tanep3/PicoW_Youtube_Player/hardware/case/slim-v3/stl/README_JA.md

# SLIM v3 試作STL — 最初に開くファイル

- 一括配置：00_all_parts_A1mini.stl を1つだけ読み込む
- 個別配置：01_shell.stl、02_lid.stl、03_button_row_1.stl、04_button_row_2.stl を読み込む
- **一括版と個別版を同時に読み込まないでください。部品が重複します**
- 単位mm・倍率100%。本体の横幅64mmになっていることを確認
- 一括配置の外接寸法140×56.6×24.4mm。A1 miniの180mm角内に収まる4部品
- LCD保持板05/06は廃止。4つのLCD爪は本体に一体化済み
- v3の本体とv3の蓋を組み合わせて使用。まず電子部品を入れず蓋の掛かりを確認

STL ZIPには5つのSTL、一括配置プレビュー、組立説明図、検査JSON、書出し・検査用スクリプトを含みます。Blenderファイルとモデル再生成ソースは別配布のBlender ZIPです。

## 設計と組立の詳細

v2試作の「蓋が緩い」「LCD保持板を入れづらい」「Picoを爪の下へ入れられない」を受けた改訂です。v2ファイルは変更していません。今回はBlenderモデルと、4部品の試作STLを用意しています。

**実物の嵌合・材料強度は未検証です。CADでの閉状態と挿入経路の確認に合格しても、印刷成功やクリック感を保証するものではありません。無理に押し込まず、まず部品なしで蓋を試してください。**

## 変更点

1. 蓋：壁への掛かり量を0.20→0.40mm、掛かり肩の奥行き遊びを0.25→0.12mm、位置決めリングの片側隙間を0.30→0.15mmに変更
2. LCD：別体の上下保持板を廃止し、本体一体の四隅の弾性爪に変更。ガラス窓と右FPCを避け、PCBの上下端の角を保持
3. Pico：上から被さる本体爪を撤去。左2つの穴周辺の座と、ボタン列間の中央支柱で下から支え、蓋側の4本の穴位置決めピン＋肩で移動を制限
4. 内深さを20→22mm、Picoを蓋側へ2mm移動。USB口を背面まで開け、USB金属部が出た基板も背面からまっすぐ入れられる形に変更

正面の窓、4ボタンの中心・軸穴・座面、側面の波形は維持しています。ロゴはありません。右側のPico穴の下に固定腕を設けず、スイッチの差込み経路を空けています。

## 主要寸法（mm）

- 基準外形：64×32×26.8。波形を含む最大横寸法は約64×32.7
- 前内面Z0、蓋内面Z22、前外面Z−2.4、蓋外面Z24.4
- LCD実測：30×24.02×3.2、原点X4/Y4.1/Z0
- 窓：23×13.8、PCB左上から右0.9・下5.3。開口X4.9〜27.9、Y9.4〜23.2
- LCDヘッダは正面下側。FPCは正面右側へ1mm
- Pico：51×21×1、原点X5/Y2.8/Z16.8、USB左
- Picoソケットの仮定最下部Z8.3、ボタンレール上端Z6.05。隙間2.25（v2は0.25）
- 仮定RFシールド上端Z21、蓋内面との隙間1.0
- 4ボタン中心：X43/56、Y10/22。ポケット6.2角、軸穴φ4、外面から座面1.6

Zは正面から背面に向かう方向です。22mmは基準面間の内深さであり、支持材を含めた全域が空洞という意味ではありません。

## Picoの保持と位置合わせ

公式図の穴はφ2.1±0.05、47×11.4の配置です。ケース内の中心は(7,7.6)、(7,19)、(54,7.6)、(54,19)。基板厚1mmとヘッダ列中心Y4.41/22.19も公式寸法に合わせました。

- 本体支持：左2穴の周囲のφ3.2座＋中央支柱X41.2〜44/Y14.7〜17.3。中央支柱はアンテナ領域の手前
- 左座には蓋ピン用のφ2.3逃げを設けています
- 蓋：4穴に入るピン。対角2本はφ1.65、残り2本はφ1.30で、4本全てをきつく拘束しない設定
- ピン先端には0.4mmの導入テーパ。先端Z16.15、基板上面Z17.8
- 蓋の押さえ肩はφ3.2、下端Z17.92。基板上面との公称隙間0.12
- 本体の左辺・上辺には上から被さらない位置合わせガイドがあります。Picoを左と上のガイドに合わせて置き、ピンが4穴に入るのを確認して閉じてください

0.12mmは基板を曲げて強く締め付けるための圧縮量ではなく、動きを制限する隙間です。蓋爪側の奥行き遊びも最大0.12mmあるため、積み上げ上の基板移動余裕は最大約0.24mmとなり得ます。無負荷で完全にがたゼロになることや、実ソケットが支柱と干渉しないことは実機確認が必要です。

公式出典：
- https://datasheets.raspberrypi.com/picow/pico-w-product-brief.pdf （機械図）
- https://datasheets.raspberrypi.com/picow/pico-w-datasheet.pdf （基板・穴・アンテナ仕様）

穴の寸法は周囲の任意の大きさの押さえ面まで安全と保証するものではありません。実基板の部品・はんだ・ソケットを目視して、φ3.2の接触面に重ならないことを確認してください。アンテナ周囲の樹脂もRF性能へ影響し得るため、通信距離は未検証です。

## LCDの四隅爪

- 爪位置：X6.1/32.0、PCBの上端と下端の計4か所
- 梁幅2.0、厚0.70、根元Z−1.2、保持肩Z3.35
- 根元を内側へ掘り込み、有効腕長4.55。外側の前板は1.2mm残るため貫通穴にはしません
- PCB端への掛かり0.25、想定外向き移動0.30、厚さ方向の遊び0.15
- 外向きの空きは上0.75・下0.58。根元まで分離溝があり、固定柱ではなく実際に曲げられる形
- 挿入側に斜面。ガラス窓やFPCではなくPCB四隅を押して装着します

接触可能な実PCBの縁、ガラス外周、背面部品は未実測です。まず実LCDで爪がPCBだけに掛かることを確認し、ガラスやFPCに力が入る場合は中止してください。爪を外す場合は先にPicoを外し、爪をわずかに外へ逃がします。

## 組立順序：LCDの経路を含む

1. 蓋、Pico、ボタン保持板を外した空の本体から開始
2. LCDを最終位置より右（ボタン側）へ5.5mmずらす。PCB左上はX9.5/Y4.1。ヘッダ下・FPC右の向きを保つ
3. その位置で背面からまっすぐ下ろし、PCBの前面をZ6.8（前板内面から6.8mm）付近に置く。PCB後面はZ10.0
4. この高さのままLCDを左（窓側）へ5.5mm滑らせて最終X4へ。左側の高いPico座の下を通す。ヘッダやFPCを座に引っ掛けない
5. 最終位置で四隅のPCB縁を少しずつ押し、4つの爪を越えて前板へ座らせる。ガラス面を押さない
6. スイッチ4個を背面からまっすぐ各ポケットへ入れる。実端子がレール用の逃げに沿うことを確認
7. 上下段の保持板をLCD側から右（+X）へ滑らせる。Picoはまだ載せない
8. 配線と実ソケット・はんだを確認してからPicoを背面からまっすぐ下ろす。USBは背面まで開いた左口へ通る。左・上の位置合わせガイドに寄せる
9. 蓋の4ピンをPicoの4穴へ合わせ、配線を噛まないことを確認。左右の爪が順に掛かるまで押す

LCD仮置き経路の公称最小隙間は、左座とのX方向0.9、FPCと中央支柱のX方向0.7。左へ滑らせる高さでは、PCB後面Z10と左腕下面の隙間が約1.38あります。手で保持するための目安であり、治具なしでこの数値が自動的に決まるわけではありません。LCDはPico・ボタン板より先に入れてください。

蓋を外すときは側面の小さい解除孔から爪を少し内側へ押して順番に外します。工具を電子部品へ突き込まないでください。

## 蓋のたわみ

- 梁厚0.9、幅3.4、根元の分離位置Z21.5
- 爪先Z13、肩Z15、有効腕長6.5。v2より長くして、掛かり増加による曲げを抑制
- 壁越えのたわみ0.4、掛かり肩の遊び0.12、リング片側隙間0.15
- 単純な小変形片持ち梁式による公称根元ひずみ目安：約1.28%。LCD爪は約1.52%

これはFEA、積層方向強度、挿入力、疲労、実際の材料の評価ではありません。PETGなどの弾性を確認した材料で小さく試し、PLAを含む各材料の繰り返し着脱耐久は別途確認してください。

## 別配布Blenderセットのファイル・シーン

- YouTube_LCD_Case_SLIM_Fit_v3.blend：編集用、1 Blender単位＝1mm
- build_youtube_case_v3.py：再生成ソース。SKIP_RENDERS=1ならレンダー省略
- render_v3.py：保存済みシーンのレンダー再生成
- validation.json：寸法、閉状態の主要干渉、印刷部品メッシュ検査
- assembly_path_audit.json：独立した連続挿入経路の幾何検査
- 01〜09のPNG：外観、正面、背面、断面、分解、背面開放、蓋裏、本体内側、LCD爪詳細
- 10_assembly_guide.png：位置合わせ・支持点・積み上げ寸法の説明図

基準シーンは01_ASSEMBLED_DRAFT_mm。残りは独立コピーの説明用シーンです。PRINTは印刷物、REFは電子部品の参考外形。4つの印刷物は本体、蓋、上段ボタン板、下段ボタン板のみです。廃止したLCD板は含みません。

## 印刷・未確定事項

STLはmm、100%で使用してください。本体は正面外側をベッド、蓋は平らな背面外側をベッド、保持板は広い平面をベッドにする配置です。STLには見栄え用のBevel修飾を含めず、検査した本体メッシュだけを使っています。

レール屋根や左座の裏などのオーバーハングはスライサーで確認し、必要箇所にのみサポートを付けてください。LCD爪の細い可動溝を埋めたり、除去で爪を折ったりしないよう注意。0.70mmの爪がスライスで欠けず、連続した線として出ることを必ず確認してください。スライス済み3MF/G-code、サポート、ブリムは付属しません。

実LCDヘッダ高さ、ソケット長さ・幅・高さ、スイッチ端子・軸・ストローク、USBケーブル外装、はんだ盛り、配線曲げは未実測の部分を含みます。参考ソケット外形は49.26×2.6×8.3です。経路検査はこの剛体外形が対象で、すべての実装済み配線やはんだを保証するものではありません。端子だけの参考表示や配線曲線は全配線のモデルではありません。

本体と蓋は必ずv3同士で使ってください。v2の蓋・本体との互換性はありません。ボタン保持板の基礎寸法は維持していますが、v3同梱データを使うと取り違いを避けられます。
