tanep3/PicoW_Youtube_Player/docs/images/web-player-dark-desktop.png

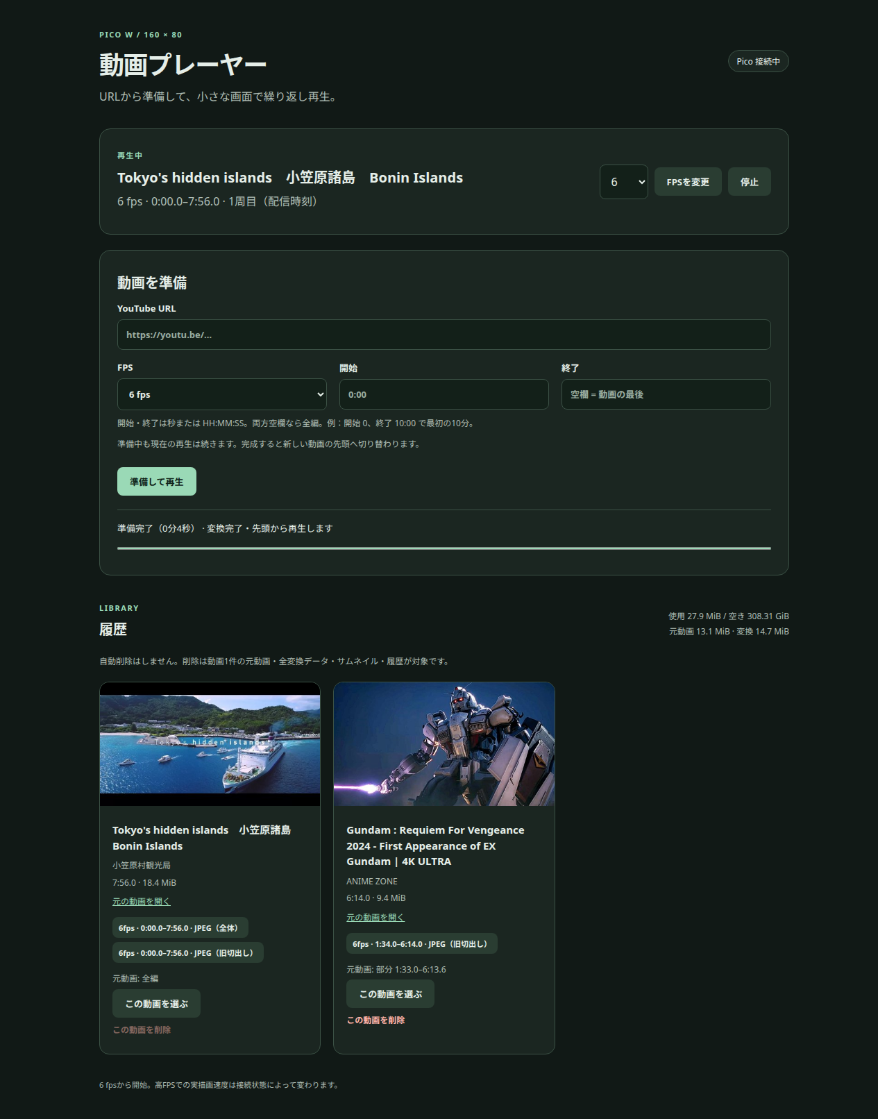
docs/images/web-player-dark-desktop.png
