tanep3/PicoW_Youtube_Player/docs/images/web-player-dark-mobile.png

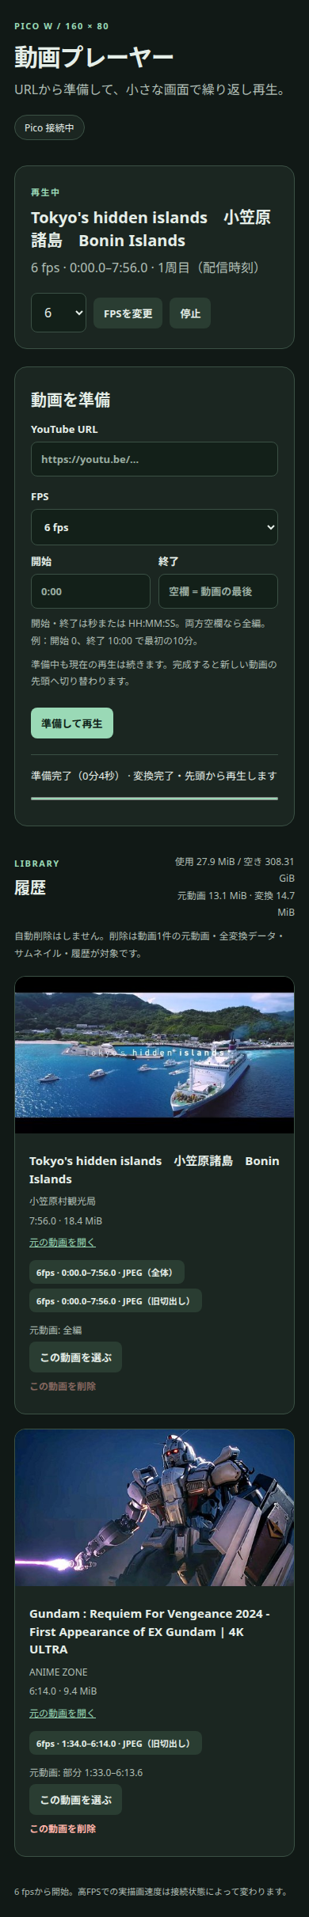
docs/images/web-player-dark-mobile.png
