tanep3/PicoW_Youtube_Player/docs/images/web-player-desktop.png

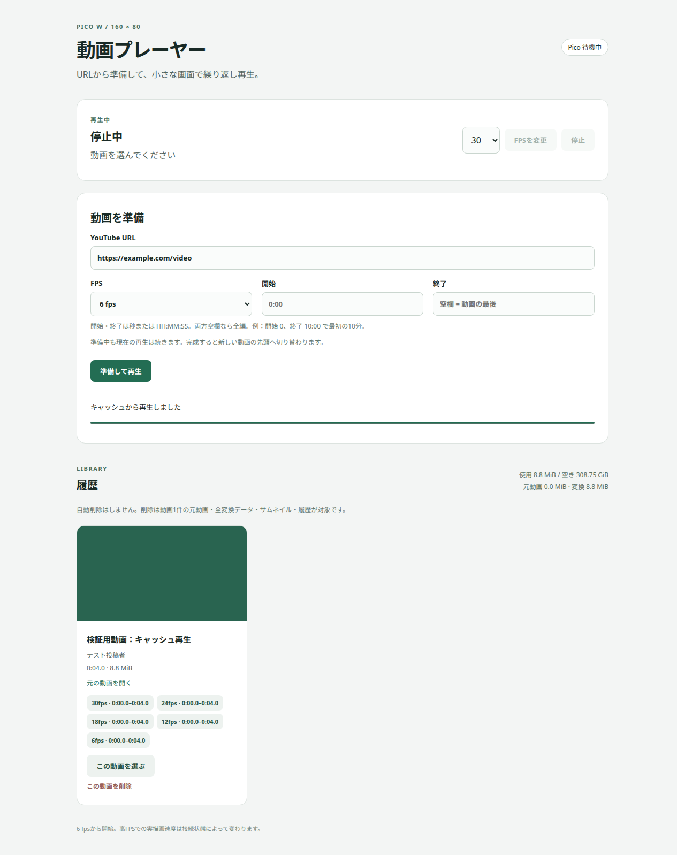
docs/images/web-player-desktop.png
