tanep3/PicoW_Youtube_Player/hardware/case/slim-v3/blender/02_front_orthographic.png

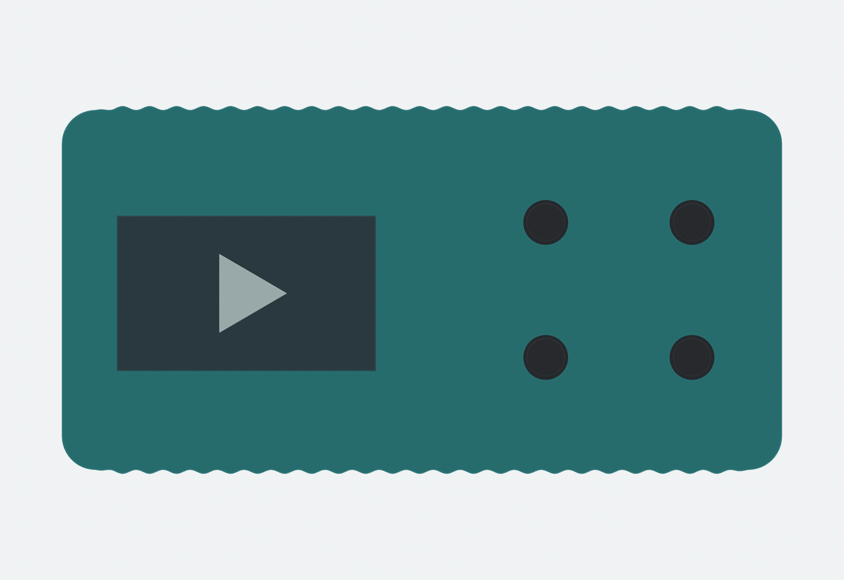
hardware/case/slim-v3/blender/02_front_orthographic.png
