tanep3/PicoW_Youtube_Player/hardware/case/slim-v3/blender/03_back_3quarter.png

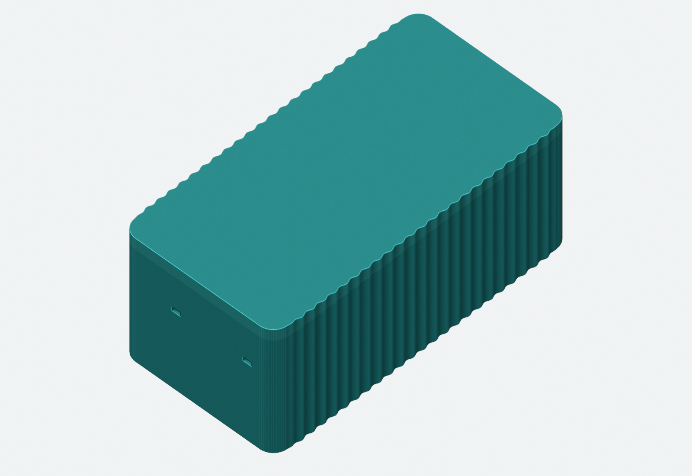
hardware/case/slim-v3/blender/03_back_3quarter.png
