tanep3/PicoW_Youtube_Player/hardware/case/slim-v3/blender/04_cutaway.png

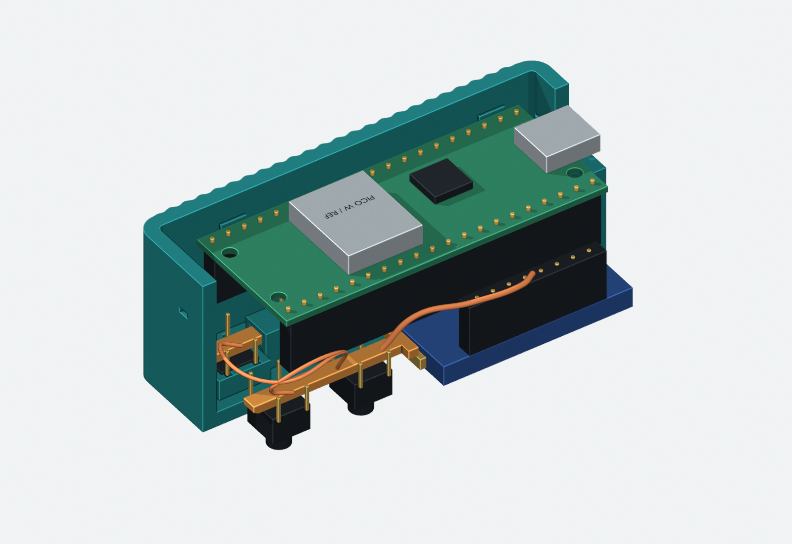
hardware/case/slim-v3/blender/04_cutaway.png
