tanep3/PicoW_Youtube_Player/hardware/case/slim-v3/blender/05_exploded.png

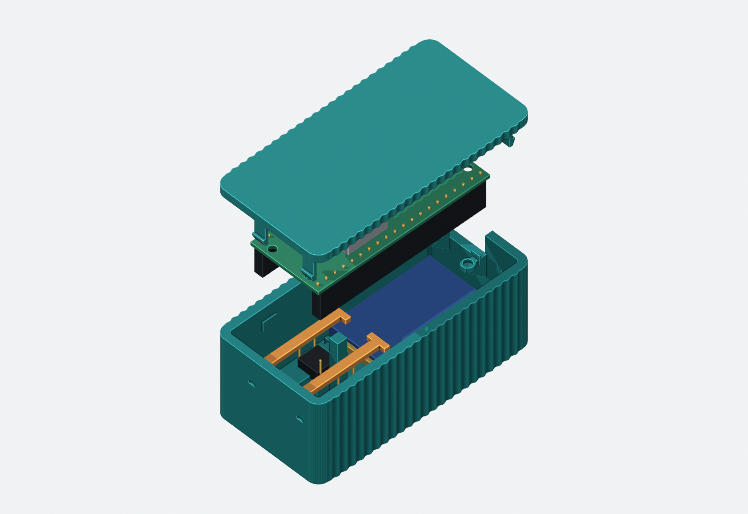
hardware/case/slim-v3/blender/05_exploded.png
