tanep3/PicoW_Youtube_Player/hardware/case/slim-v3/blender/06_rear_open.png

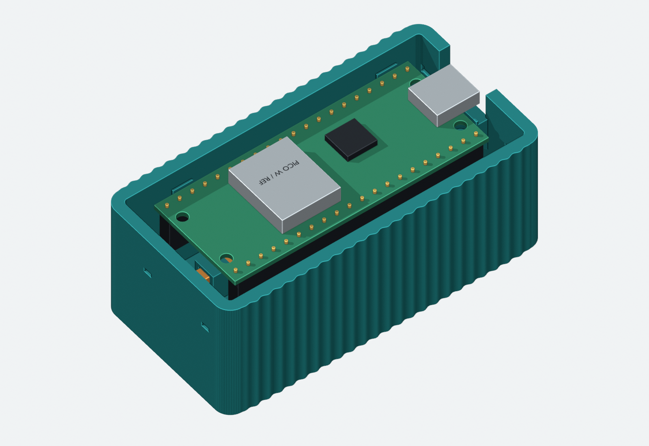
hardware/case/slim-v3/blender/06_rear_open.png
