tanep3/PicoW_Youtube_Player/hardware/case/slim-v3/blender/07_lid_snap_detail.png

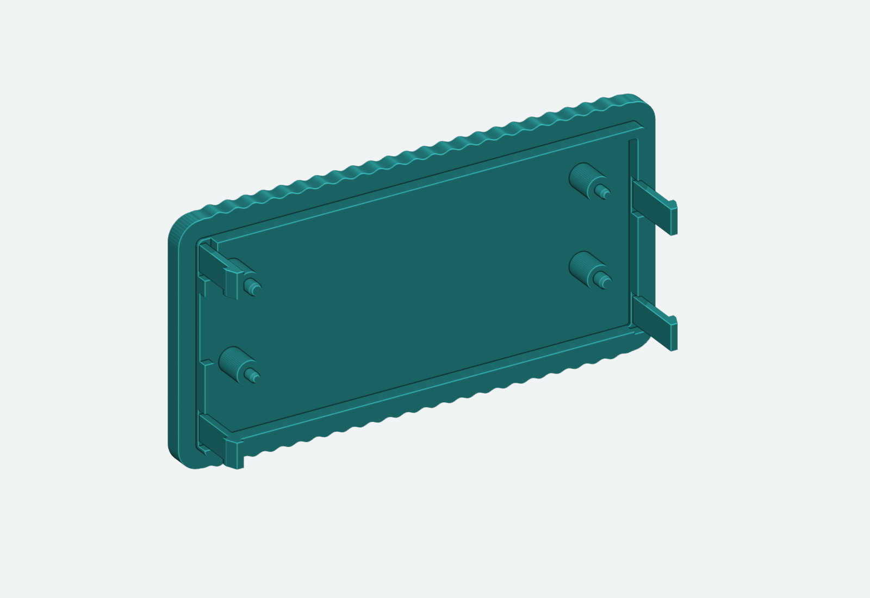
hardware/case/slim-v3/blender/07_lid_snap_detail.png
