tanep3/PicoW_Youtube_Player/hardware/case/slim-v3/blender/08_integral_tabs_and_hole_seats.png

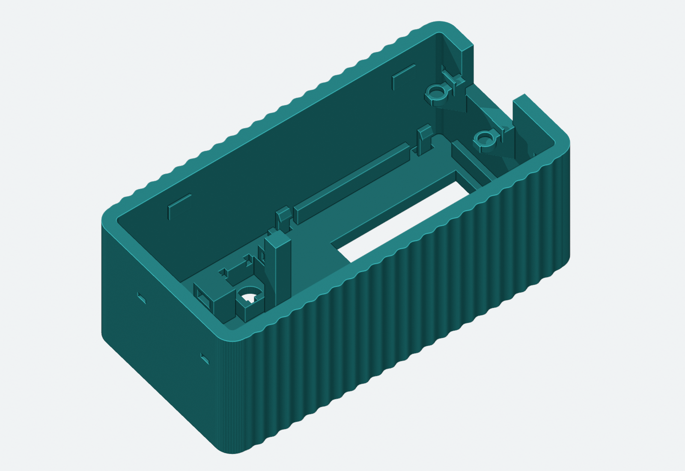
hardware/case/slim-v3/blender/08_integral_tabs_and_hole_seats.png
