tanep3/PicoW_Youtube_Player/docs/YOUTUBE_REQUIREMENTS_INVENTORY.md

# YouTube構築へ向けた既存要件の棚卸し（実装前の記録）

> 実装開始後の追記: 単一動画ループ、取得/変換中の現在再生継続、完成後先頭切替、SQLite/data、1動画全データの確認削除（停止/取消し後）、全編既定と開始終了、範囲別元/変換キャッシュが確定した。現実装・起動・検証・残る依存ブロッカーは[Webプレーヤー仕様](WEB_PLAYER.md)を参照。以下の「未決」「未実装」は棚卸し時点の履歴。

2026-10-08。検証フェーズをFixし、Wi-Fi `192.168.0.120` / 6fpsへ戻して次フェーズへ進むというユーザー決定を記録する。最新指示で**AI/Gemini連携は今回スコープ外**。URL直接入力、FPS選択、キャッシュ/履歴、使用量表示/手動削除を対象にする。ハブ到着後は有線化・30fps改訂と、サーバーIP `.120`を保持する計画。移行方法は未決で、今回は適用していない。ここでは文書の要件調整だけを行い、新実装・常駐化・恒久有線化・コミットを開始していない。

## 根拠

- [README](../README.md): 現プロジェクトは既存JPEG連番の映像検証。YouTube取得、検索UI、常駐サービスを含まない。160×80、RGB565、RAW/JPEGのTCP比較、再接続、単調時計、エンドレス再生を実装している。
- [有線/FPS検証](diagnostics/WIRED_ETH0_PREP.md): 有線RAW6fps描画6.00fps、32fps設定で最高実描画約30fps。高fpsで使った素材は6fps画像の速送りで、ネイティブ高fps動画の検証ではない。Wi-Fi運用には再送・フレーム破棄・再接続による停止が残る。
- 次フェーズのユーザー要望（親チャットからの伝達）: **WebでURL指定 / ffmpegで160×80へ変換 / 24時間連続再生 / 動画・変換データのキャッシュ / 履歴から再選択 / 使用量表示と手動削除**。履歴は**サムネイル、動画タイトル、投稿者/チャンネル名**を表示し、表示メタデータもキャッシュする。WebのFPSドロップダウンは **6 / 12 / 18 / 24 / 30fps**。初期6fpsで構築し、将来30fpsへ改訂する。有線移行後もPi5のサーバーIP `.120`を保持する計画。
- 先に検討した自然文AI検索/Gemini連携は、最新ユーザー指示により今回の対象から外れた。登録済Gemini CLI/キー設定には触れず、AI実装・実験を行わない。

## 機能の現況

Pi5で`/usr/bin/ffmpeg`と`/usr/local/bin/yt-dlp`の実行ファイルが存在することを読み取り確認した。yt-dlp/ffmpeg更新は別タスク担当中。この文書更新では取得・検索の実行やインストールをしていない。現在のPython依存はPillowだけで、Web用の依存は未選定。動画とメタデータ取得へのyt-dlp活用を検討する。検索APIやAI連携を追加するという決定ではない。

Gemini CLIの実動作、認証継承、モデル利用可否は未検証のまま。今回スコープ外となったため、検証のためのCLI実行や認証/秘密値の読取りも行わない。

| 要件 | 利用できる現基盤 | 次フェーズで必要なもの |
|---|---|---|
| WebでURL指定 | Pi5上のPython映像サーバー。検索/指定UIはない | URL入力、取得/変換/再生の開始と状態表示 |
| 動画取得 | 既存JPEGを読み取るだけ | URL等からの取得手順と失敗時の扱い |
| WebのFPS指定 | 未実装。既存CLIは任意の正整数fpsを扱える | ドロップダウン6/12/18/24/30、変更時の変換と切替 |
| ffmpeg変換 | ユーザー申告の変換コマンドをREADMEへ記録済み。自動実行は未実装 | 取得動画から160×80・指定FPS（初期6fps）への変換、出力先、進捗/失敗の扱い |
| 元動画・変換データのキャッシュ | 未実装 | videoIDで元動画の重複取得を避け、変換条件別に完成データを再利用する |
| 履歴から再選択再生 | 未実装 | サムネイル・動画タイトル・投稿者/チャンネル名を表示し、キャッシュから再生する |
| メタデータのキャッシュ | 未実装 | 履歴表示用メタデータとサムネイルを保持し、再選択のたびの再取得を避ける |
| 使用量表示・手動削除 | 未実装 | キャッシュ使用量の表示、削除対象/範囲の確認。自動削除しない |
| Pi5からPicoへ送る | JPEGをPillowでRAW RGB565へ変換してTCP配信。PWF2固定ヘッダー、再接続、色補正あり | Web操作と既存配信の接続、動画切替 |
| 24時間連続再生 | 単一JPEGフォルダーをエンドレス再生。切断後も共有再生時刻から継続。24時間耐久は未試験 | 単一動画ループ/複数動画連続の仕様、追加/停止/切替、失敗復帰と24時間耐久検証 |
| 運用 | 手動起動、一台のPico向け。既存本番16150は使わず、試験は16151 | 新システムのポート、継続稼働と再起動の方法、設定先。今回の棚卸しではサービス変更を行わない |

## 確定したキャッシュ・履歴・容量管理

- **元動画:** videoIDを識別子として、同じ動画の重複ダウンロードを避ける。
- **変換済データ:** `videoID + 解像度 + FPS + 変換条件`で区別する。異なるFPSやクロップ等の条件を同じ完成キャッシュとして再利用しない。変換条件の表現と保存形式は未決。
- **完成状態:** ダウンロード/変換の途中・失敗したファイルを完成キャッシュにしない。完成データだけを再利用可能な履歴再生対象として扱う。未完データの保存/再開/手動削除の扱いは設計時に決める。
- **履歴表示:** サムネイル、動画タイトル、投稿者/チャンネル名を表示する。表示メタデータもキャッシュし、再選択時には保存済み情報を利用する。
- **再選択:** 完成済みの同じ変換条件があれば再生に再利用する。元動画だけがある場合は、指定FPS等の変換データを作る。元動画・変換済データ・メタデータの完了状態を混同しない。
- **容量管理:** 使用量表示と手動削除を実装する。自動削除しない。削除する対象と範囲を利用者に確認できるようにする。再生中/変換中の対象への削除操作は未決。

### メタデータ欠損時の表示案（未確定）

- サムネイル欠損: 共通プレースホルダー画像。
- タイトル欠損: 「タイトル未取得」とvideoIDを表示。
- 投稿者/チャンネル名欠損: 「投稿者不明」を表示。
- 動画/変換データが完成していれば、表示メタデータの欠損だけで再生を禁止しない案。メタデータの再取得を手動操作にするか、取得時に再試行するかは未決。

## 現在維持する条件

- 今回の復元先はPi5 Wi-Fi `.120`、Pico `.173`、6fps。PicoのST7735S/160×80/SPI0配線・Yoffset24・色補正は校正済み。
- ハブ到着後の有線移行でもサーバーIP `.120`を保持する計画。Wi-Fiの扱いと移行手順は未決で、試験時の一時IP `.116`を恒久接続先にはしない。
- 元JPEG `/home/tane/Videos/voltesV_6frame` は変更しない。新取得/変換の出力先は次フェーズで決める。
- 初期ffmpeg式はREADMEのユーザー申告を保持する。クロップ、アスペクト比、品質を変更する場合は新仕様として扱う。
- 音声は現検証に含まない。次フェーズで音声対応するという確定要件はない。
- 他の本番HTTP/timer/サービス、既存E-inkプロジェクト、共有SDK/driver、Wi-Fi秘密値は対象外。SSH、gitlink、remote設定、git pushは行わない。
- Gemini CLIと登録済キー設定は維持する。AI/Gemini連携は今回構築する機能に含めず、URL直接入力と履歴再生はGeminiに依存させない。

## 実装前にまとめて決める点

1. WebはURL指定を受け付ける。対象URLの範囲（YouTube以外も含むか）、操作端末、LAN内の利用範囲、必要な操作を決める。
2. キャッシュの保存先、履歴/メタデータの保存形式、videoID判定、変換条件キーの構成、完成判定と未完データの扱い。既存JPEGテストとは別の領域を使う。現`server/streamer.py`は全フレームをRAMへ保持するので、長時間動画と24時間のループ運用を区別して容量設計する。
3. 使用量の内訳/表示単位、削除対象と範囲（元動画のみ/変換データのみ/両方/履歴情報・サムネイルも含むか）、確認方法。再生/変換中は削除禁止にするか待機させるか等は未決。容量不足時も勝手に既存キャッシュを自動削除しない。
4. 24時間連続再生は要求済み。一動画ループかプレイリストか、新規指定の即切替/現在動画の終了待ち、停止/再開、取得失敗時の扱い。常時運用の起動/再起動方法。
5. WebのFPS候補は6/12/18/24/30で確定。条件一致キャッシュを再利用し、未キャッシュのFPSへ変更する際の変換中の再生/切替時点は未決。初期は校正済み6fps/160×80で進める。ハブ到着後の30fpsはネイティブ30fps変換と実受信/描画の再測定を伴う別改訂にする。
6. メタデータ欠損時の上記表示案、再取得/再試行、投稿者名とチャンネル名が異なる場合の表示、サムネイルの保存方法。
7. 有線移行後も`.120`を保持する具体的な方法と、Wi-Fi/他サービスへの影響を抑える移行手順。IP保持の方針を、両インターフェースに同じIPを無条件設定する指示と解釈しない。

## 推奨する初期スコープ（未確定）

- まずWebのURL入力→元動画キャッシュ→ffmpeg160×80/指定FPS変換キャッシュ→校正済みRAW TCP再生を通す。既存配信・再接続の基盤を利用する。
- 履歴カードにサムネイル/タイトル/投稿者を表示し、完成済み条件の再選択でダウンロード/変換を省ける動作を確認する。FPS選択、進捗/失敗/再生状態、使用量表示と手動削除を含める。
- 24時間連続再生の初期検証は、一動画を反復して切断/取得失敗/再起動からの復帰を確認する案。プレイリストの要否は別途決める。この案を確定仕様とは扱わない。
- 有線化/30fps/IP移行はハブ到着後。まず現在のWi-Fi `.120` / 6fpsで構築する。恒久化やIP移行をこの棚卸しで実行しない。

この文書は棚卸しであり、未決点を仮定して新しいUI/API、取得処理、サービスを作成していない。
