tanep3/PicoW_Youtube_Player/hardware/case/slim-v3/stl/00_all_parts_A1mini.stl

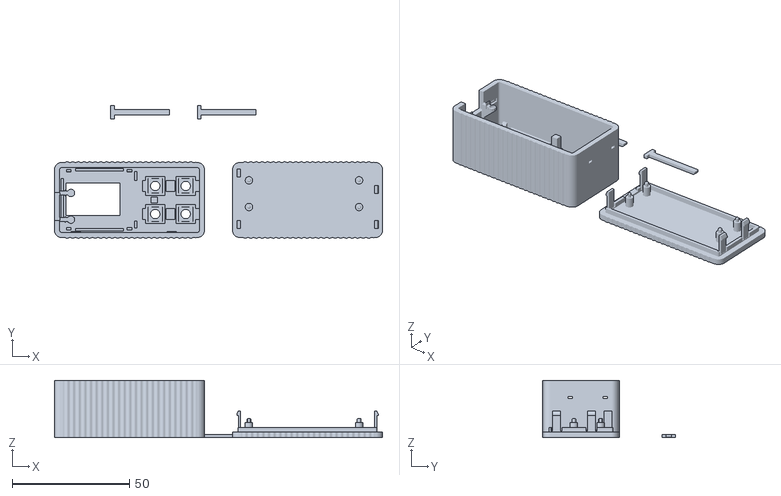
[picture p16: CAD file, 2026-10-10]
hardware/case/slim-v3/stl/00_all_parts_A1mini.stl
140.0 x 56.6 x 24.4
