tanep3/PicoW_Youtube_Player/hardware/case/slim-v3/stl/01_shell.stl

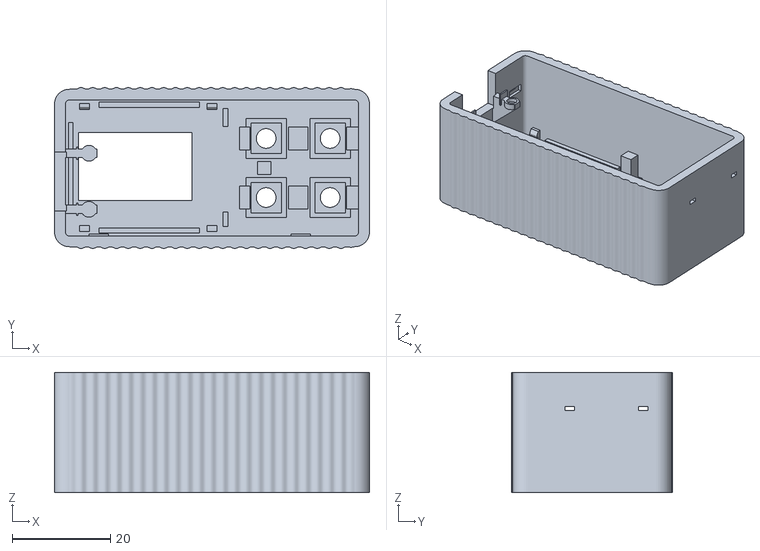
[picture p17: CAD file, 2026-10-10]
hardware/case/slim-v3/stl/01_shell.stl
64.0 x 32.7 x 24.4
