tanep3/PicoW_Youtube_Player/hardware/case/slim-v3/stl/04_button_row_2.stl

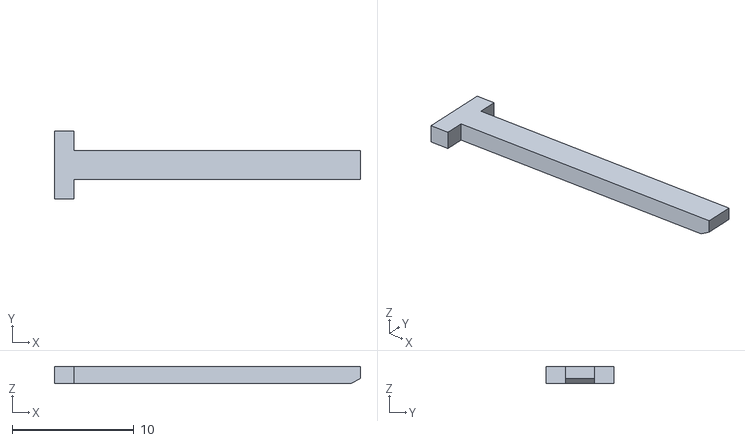
[picture p18: CAD file, 2026-10-10]
hardware/case/slim-v3/stl/04_button_row_2.stl
25.1 x 5.60 x 1.40
