tanep3/PicoW_Youtube_Player/hardware/case/slim-v3/stl/02_lid.stl

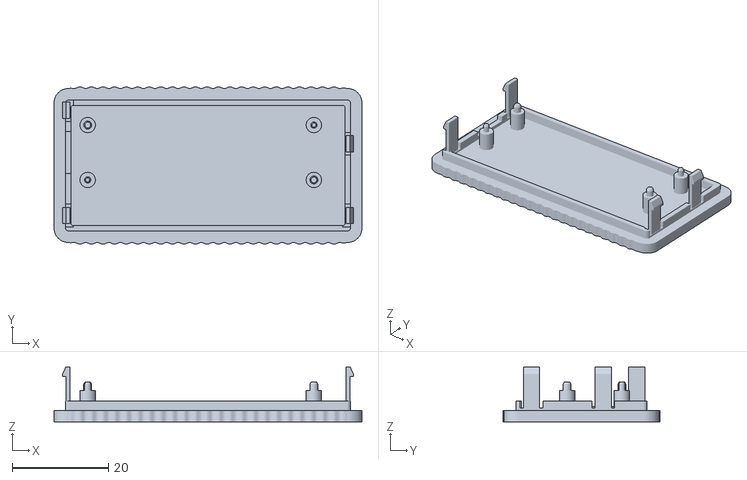
[picture p19: CAD file, 2026-10-10]
hardware/case/slim-v3/stl/02_lid.stl
64.0 x 32.7 x 11.4
