tanep3/PicoW_Youtube_Player/(list of files, cad)

Other CAD files:
hardware/case/slim-v3/stl/03_button_row_1.stl
hardware/case/slim-v3/blender/YouTube_LCD_Case_SLIM_Fit_v3.blend
