tanep3/PicoW_Youtube_Player/docs/history/DEVELOPMENT_LOG.md

> 2026-10-10に従来READMEを移した開発記録です。本文・測定値・当時の判断を保持し、相対リンクの参照先だけ移動先へ合わせました。現在の組立・運用は[README](../../README.md)を参照してください。SPI1の配線案など、採用していない過去の案も含みます。

# Pico W JPEG連番プレーヤー（6 fps 映像テスト）

既存のJPEG連番をRaspberry Pi 5からTCPでPico Wへ送る映像テストです。RAW/JPEG比較版を同一Pico Wで実機試験済みです。元画像は読み取りのみです。音声は含みません。後から追加したYouTube URL指定Webと専用userサービスは末尾の「Web URLプレーヤー」に記録しています。

## 確認した入力

`/home/tane/Videos/voltesV_6frame` に `frame0001.jpg`〜`frame0588.jpg` の588枚があり、欠番・余分なファイルはなく、すべて160×80 JPEGでした。6 fpsでは98秒分です。作成時のffmpegコマンドはユーザー申告のものをそのまま記録します。

```sh
ffmpeg -i $1 -vf "crop=440:242:(in_w-440)/2:(in_h-220)/2,scale=160:80,fps=6" -q:v 5 frame%04d.jpg
```

## 構成と通信

- `server/streamer.py`: Pillowで全フレームを読み込み、RGB565または品質90 JPEGで送信します。RAWでは約15.1 MBをメモリに保持します。TCP切断後は再接続を待ち、動画の経過位置から配信を続けます。
- `diagnostics/server/lcd_pattern.py`: 同じ通信方式で黒地・白1px外枠・赤緑青の細線と太線を固定表示し、液晶の位置と色を確認します。
- `pico/pico_player.c`: Wi-Fi接続後、PWF2ヘッダー20バイトとRAW/JPEG画像を完全受信し、選択モードに応じてJPEG展開とSPI表示を行います。切断や不正ヘッダー時に接続し直します。受信済みフレームを保護する2画面バッファです。遅延比較後、Wi-Fi省電力を無効にしています。
- `pico/config.example.h`: Wi-Fiと液晶調整の設定例。実値はローカルの `config.h` に記入します（Git除外）。
- [現在の配線図と対応表](../../docs/wiring.md)、[完成形の概念配置と別配線案](../../docs/compact-layout.md)。BLKは現在未接続で、基板仕様は未確認です。

新ファームの1フレームは `PWF2` の20バイトヘッダー（magic、連番、幅、高さ、データ長、モード）とRAW 25,600バイトまたは可変長JPEGです。RAWでは計25,620バイト、6fpsで153,720バイト/秒（約1.23 Mbit/秒、TCP等のオーバーヘッドを除く）です。サーバーは単調時計で6 fpsを管理し、遅れたフレームを飛ばします。クライアントは2画面分のバッファでTCPの分割受信に対応します。Picoは同じTCP接続の逆方向にSTA MAC、受信・展開・描画・破棄フレーム数、JPEG展開とSPIの所要時間を毎秒PWS3の80バイトで返します。音声と同期信号はありません。

## 必要なもの

- Raspi5: Python 3、Pillow (`python3-pil` または `python3 -m pip install -r server/requirements.txt`)
- Pico Wビルド: Pico SDK、CMake、ARM GCC。Raspi5では `/home/tane/dev/PicoW/pico-sdk` と `/usr/bin/arm-none-eabi-gcc` を確認済みです。
- 実機: Pico W、80×160 SPI液晶。裏面基板印字は `DRIVER IC: ST7735S` と確認済みです。固定画面で、ユーザーが `LCD_Y_OFFSET=24` の四辺の白枠と赤・緑・青の発色を確認しました。

C SDKを選んだ理由は、SPIとWi-Fiを並行して扱うためのSDKとクロスコンパイラが既にあり、25,600バイトの連続SPI転送と切断復帰を固定メモリで実装できるためです。ソース自体は6 fpsで、動画由来のコマ送り感とネットワーク遅延による停止は区別して評価します。

## サーバーの実行

ポートは設定可能で、初期候補は **16151** です。既存本番の16150は使用しません。Picoから接続する場合はRaspi5のLANアドレスで待ち受けます。例:

```sh
cd /home/tane/dev/PicoW/PicoW_Youtube_Player
python3 -m server --host 0.0.0.0 --port 16151 --frames /home/tane/Videos/voltesV_6frame --compensate-colors
```

Ctrl+Cで停止します。`--once` は1周送信後に終了し、省略時はエンドレスです。`--compensate-colors` は診断画面で確認された反転と赤/青入れ替えをPi5側のJPEG→RGB565変換後に補正します。Pico側の `LCD_INVERT=1`、`LCD_MADCTL=0x60` はそのままです。送信が詰まった場合は既定の2秒（`--send-timeout` で変更可）でそのTCP接続を切り、Picoの再接続後に動画時刻から続けます。デフォルトはローカルホスト待受で、LAN公開は明示指定した場合だけです。起動前にポートの空きと接続先LANアドレスを再確認してください。サーバーは一度に1台へ配信します。

Pico接続中はサーバーに `received`, `displayed`, `dropped`, `display_rate`, `SPI` と配信側の5秒ごとの送信速度・スキップ数・動画内フレーム番号が出ます。最初の起動時に3秒間、白枠と赤・緑・青の帯を表示します。固定診断ではユーザーが色と四辺の枠を確認しました。動画が6 fpsのため、通信が正常でも毎秒6コマ固有の動きになります。

## Pico側の設定とビルド

1. 既存のローカル `config.h` を保持し、必要な場合だけWi-Fi設定、`SERVER_IP`、ポートを本人がローカル編集します。`pico/config.example.h` は新規環境向けの見本です。秘密値を表示・コミットしないでください。**転送前に `--clean-first` で再ビルド**してください。
2. BLK内部回路は未確認です。BLK未接続の現在の配線で映像表示は確認済みです。表示位置・向き・色順は `config.h` の `LCD_X_OFFSET`, `LCD_Y_OFFSET`, `LCD_MADCTL` を調整します。BGR切替は `LCD_MADCTL` の `0x08` ビット、反転は `LCD_INVERT`。現在のブレッドボード配線は `DISPLAY_PROFILE=0`、完成形の別配線案は `DISPLAY_PROFILE=1`。本テストはBLK制御ピンを使いません。
   現在の設定は `LCD_INVERT=1`、`LCD_Y_OFFSET=24` です。26から25へ変えても上端のノイズ行と下端の白枠欠けが残ったため、もう1行上げました。固定画面で色はPi5側の `--compensate-colors` を使って確認しました。
3. ビルド手順:

```sh
cd /home/tane/dev/PicoW/PicoW_Youtube_Player
PICO_SDK_PATH=/home/tane/pico/pico-sdk cmake -S . -B build -DPICO_BOARD=pico_w \
  -DCMAKE_BUILD_TYPE=Release -DPLAYER_LCD_GAMMA_LGFX=ON
cmake --build build --clean-first -j2
```

Pico側IPv4は既定で `192.168.0.173/24`、ゲートウェイとDNSは `192.168.0.1` に固定します。これらはPi5の現行LAN設定から確認した値で、`CMakeLists.txt` の `PLAYER_STATIC_IP`, `PLAYER_GATEWAY`, `PLAYER_NETMASK`, `PLAYER_DNS` をCMakeオプションで変更できます。ルーター側のDHCP予約や他機器の設定は変更しません。Pi5側が代理ARPを返すため、Pi5からのpingだけでは `.173` に他機器がいないことを証明できません。ルーターの割当範囲・予約状況は別途確認してください。

完成形候補のGP9〜13/SPI1配線を使う場合は、同じSDKで別buildディレクトリを指定し、`-DDISPLAY_PROFILE=1 -DPLAYER_LCD_GAMMA_LGFX=ON` を付けて再ビルド・転送が必要です。既存GP17〜21/SPI0配線の既定値は0です。[背中合わせ概念案](../../docs/compact-layout.md)と[現配線](../../docs/wiring.md)を参照してください。寸法・端子位置・BLK回路は現物確認が必要です。

生成物は `build/pico_w_jpeg_player.uf2` です。PWF2比較版は同一Pico Wへ書込み済みで、Flash Verify 100% OKを確認しました。BLKを勝手にGPIOへ接続しないでください。

## 固定画面の診断

動画配信を止めてから、同じ16151番で次を起動します。Picoへの再書込みは不要です。

```sh
python3 -m diagnostics.server.lcd_pattern --host 0.0.0.0 --port 16151
```

黒背景、四辺の白1px枠、上端内側の赤・緑・青各1px線と、少し下に同順の8px帯を出し続けます。上端にノイズ行がある場合は太線の色で判断します。Ctrl+Cで終了します。色と位置を確認してから動画配信へ戻してください。

実画面で「黒→白、赤→黄、緑→紫、青→水色」が観察されたため、Picoのファームを変えずに反転と赤/青の入れ替えを打ち消すオプションを設けました。ユーザーはこれを使った固定画面で、黒背景・白枠・赤緑青の色を確認しました。動画配信も同じ `--compensate-colors` を使います。

```sh
python3 -m diagnostics.server.lcd_pattern --host 0.0.0.0 --port 16151 --compensate-colors
```

## テスト

```sh
python3 -m unittest discover -s tests -v
python3 - <<'PY'
from pathlib import Path
from server import streamer as server
frames = server.load_frames(Path('/home/tane/Videos/voltesV_6frame'))
print(len(frames), len(frames[0]), len(server.packet(0, frames[0])))
PY
```

新PWF2版の期待値は `588 25600 25620` です。ソフト単体試験は液晶の発色、向き、BLK点灯、実機での安定6 fpsを証明しません。

実機のエンドレス試験では動画時刻が1周98秒を超えて先頭側へ戻ることを確認しました。TCPの再送・送信待ちとPico側のフレーム破棄があり、最初の約98秒でPicoの描画カウンタは約382枚（約3.9 fps）増加しました。SPI転送は通常約15.6ms/画面で、167msの6fps枠より短いです。ソース時刻は6fpsで進み、遅れたフレームを飛ばすため、588枚すべてが画面に到達したという意味ではありません。安定した6fps描画は今後の通信経路改善事項です。

動きの内訳を調べる場合は通常の動画コマンドに `--trace-motion` を加えます。現行TCPのまま、サーバーの送信間隔・`sendall` の待ち時間と、Picoが毎秒返す受信/描画/破棄数を記録します。最初の101秒の実機計測ではPico描画418枚（約4.14fps）、両スロット満杯による破棄95枚、描画0枚の1秒区間18回（連続最長約7秒）、Pi5の送信待ち最大約6.9秒を観測しました。元動画の6fpsによる一定のコマ送りに加え、通信停滞と到着後の連続描画が不規則なカクつきの原因です。

Pi5のTCP状態を停止と同時に確認すると、受信窓はゼロではなく、未ACKセグメントの再送で輻輳ウィンドウが1になり、RTOが指数的に伸びていました。省電力を無効にしても停止は残ったため、サーバー側に2秒の送信期限とTCPリセットによる再接続を加えました。同じ省電力無効ファーム・同じ動画で、従来の10秒期限は122.6秒中に描画564枚（4.60fps）、送信待ち最大3.10秒、受信した約1秒間隔の状態報告で描画0枚の区間13回（連続最長3回）でした。2秒期限では110.1秒中に描画549枚（4.98fps）、送信待ち最大2.00秒、描画0枚の区間7回（連続最長1回）でした。ユーザーも長い停止の減少を確認しました。さらに241秒まで観察した結果、送信待ちは最大2秒に収まり、平均描画4.88fpsでしたが、状態報告自体が最大約5秒途切れました。この累計カウンタだけでは画面停止の厳密な最長時間は分かりません。無線状態の短期変動があるため、常に同じ改善幅になる保証はありません。安定した6fps描画は未達です。

再接続までの空白は、動画連番で追うと約3〜10秒の例があります。2秒という値はサーバーの1回の送信待ちの上限で、画面停止の上限ではありません。負荷を切り分けるため、一時的に `--fps 1` で同じRGB565フレームを75.6秒送ったところ、表示バッファ満杯による破棄は0枚でしたが、送信2秒タイムアウトは3回、再接続は4回起きました。したがって画面バッファ不足やSPI表示頻度だけでは通信損失を説明できません。無線経路とPico側のWi-Fi/lwIP受信処理を分けるには、Pico側の受信ドロップ統計や電波強度など追加の診断が必要です。比較後は6fps配信へ戻しています。

診断版ファームウェアでは、従来の32バイト `PWS1` に代えて60バイトの `PWS2` 状態を毎秒返します。Pi側 `server/streamer.py` は両形式を読めます。追加項目は10秒ごとのSTA RSSI（取得前・取得失敗時は `-127`）、lwIPのPBUF_POOL最大使用数と割当失敗数、TCP drop/memerr、Picoの受信コールバック最長実行時間と受信コールバック間の最長空白です。PBUF_POOLの現在容量は32です。統計は起動後の累計または最大値で、lwIPの一部カウンタは16ビットで折り返します。受信コールバックの時間はWi-Fiドライバ内部の処理時間を含みません。RSSI取得は受信コールバック外のメインループで行います。

この診断版を同じPico W（Flash ID `0xE661640843239D21`）へ転送し、Flash Verify 100%を確認しました。SDKは `9a4113fbbae65ee82d8cd6537963bc3d3b14bcca`、内包cyw43-driverは `c1075d4bc440422cf2b2fd12c64a1f53f77660ee` です。同じ588枚・6fps・2秒送信期限で約120秒観測した時、PWS2状態69件でRSSIは−45〜−30dBm、PBUF_POOL最大使用18/32、割当失敗0、lwIP TCP drop/memerrとも0、受信コールバック最長1,298µsでした。一方で送信タイムアウトは11回、再接続は11回起きました。Picoのpbuf枯渇やアプリ受信コールバックの長時間処理を示す値は出ていません。lwIPより前のCYW43処理、アクセスポイント、無線経路のどこで損失が起きるかは、この統計だけでは分かりません。診断版のRSSI取得が通信に与える影響も未測定です。

RSSI取得の影響を比較するため、現在のソースは `SAMPLE_RSSI=0` とし、10秒ごとの `cyw43_wifi_get_rssi()` 呼出しだけをコンパイルから外しています。PWS2の60バイト構造と残りのカウンタは同じで、RSSI欄は常に未取得値 `-127` です。RSSI有効版は `/tmp/picow_pws2_rssi_on.uf2`、無効版は `/tmp/picow_pws2_rssi_off.uf2` に保全しました。無効版も同じFlash IDのPicoへ転送し、Flash Verify 100%・PWS2の `RSSI=-127` を確認しました。この比較時にPicoで動作していたのはRSSI無効版です。RSSI呼出しは有効版ではメインループ内で行い、CYW43ドライバのioctl応答待ち上限はこのSDK設定で1秒です。実際の1回ごとの所要時間は計測しておらず、PWS2状態送信・統計読取り自体の影響もゼロとは断定できません。

同じ588枚・6fps・2秒送信期限の最初の約120秒を動画連番0〜720で比べると、RSSI有効版は送信タイムアウト10回・接続11回・表示カウンタ+253枚（約2.11fps）・破棄+27枚、無効版はタイムアウト10回・接続11回・表示+249枚（約2.08fps）・破棄+43枚でした。完了した送信の最大間隔は有効版1,962ms、無効版2,024ms。タイムアウト後の動画連番の最大空白はそれぞれ約9.3秒、約10.2秒です。これは画面の厳密な最長フレーム間隔ではありません。両版ともPBUF_POOL最大使用18/32、割当失敗・lwIP TCP drop/memerrは0。受信コールバック最長は有効版1,298µs、無効版1,395µs。取得を止めても長い送信停止は残り、今回の条件ではRSSI取得が主因とは言えません。無線状態が時間で変わるため、少数の順次比較だけで小さい影響の有無まで断定できません。無効版の別途75秒間のTCP読取では再送バイト最大216,720B、RTO最大3,488ms、輻輳ウィンドウ1のサンプル72/268でした。有効版には同じ期間のTCPサンプルがないため、再送量の数値比較はできません。

TCP切断のたびにWi-Fi参加を再実行していたため、次の比較用ファームではSDKの `CYW43_LINK_UP`（Wi-FiリンクとIPアドレスが有効）ならTCP接続だけを開き直すようにしました。リンクが落ちていれば従来どおりWi-Fi参加を試みます。無受信判定5秒、TCP監視周期5秒、1秒の再接続待ち、LCD、PWS2、RSSI無効は変更していません。旧RSSI無効版UF2は `/tmp/picow_pws2_rssi_off.uf2`、当時のTCPのみ再接続版は `/tmp/picow_pws2_tcp_only_reconnect.uf2` に保全しました。新しいTCPのみ再接続版は同じFlash ID `0xE661640843239D21` のPicoへ転送し、Flash Verify 100%と起動を確認しました。12件のソフトテストも成功しました。TCP送信の最初のパケット損失を解決する変更ではなく、再接続時の動画空白を比べるための変更です。

同じ588枚・6fps・2秒送信期限の動画連番0〜720（約120秒）では、新版は送信タイムアウト2回、接続3回、PWS2表示カウンタの増分は約559枚（約4.7fps）、破棄+54枚でした。旧RSSI無効版の同じ範囲では送信タイムアウト10回、接続11回、表示約250枚（約2.1fps）、破棄約43枚でした。新版の最初のタイムアウトは連番255（約42.5秒）、旧版は連番10（約1.7秒）でした。これは時間をずらした順次測定なので、無線状態の変動を含み、このコード変更だけでタイムアウト頻度や表示率が改善したと断定できません。

新版では送信タイムアウトのログから次のTCP接続受理まで、外部ログ時計の1秒分解能で約2秒と約7秒でした。タイムアウトを試みた動画連番から再接続後の最初の連番までの空白は3.3秒と9.5秒、旧版の最大は10.2秒です。長い動画時刻の空白は残ります。連番の空白は画面の厳密な停止時間ではありません。現行の診断には再接続時のWi-Fiリンク状態と再join有無がなく、7秒の内訳は確定できません。

省電力無効化 `cyw43_wifi_pm(..., CYW43_NONE_PM)` はWi-Fi参加前の起動時に1回呼び、PWS2の `pm_off=1` はその呼出しが0を返したことを示します。実効PMモードを後から読み戻した値ではありません。country codeはアプリに指定がなく、ローカルSDKの `cyw43_arch_init()` 既定 `CYW43_COUNTRY_WORLDWIDE` です。CYW43通信は内部ピンで動的に確保したPIOステートマシンと2本のDMAを使い、液晶は外部GP18/19のハードウェアSPI0で `spi_write_blocking` を使います。両者にSPI周辺回路やGPIOの直接競合はありません。CPU/メモリバスの同時負荷が損失に寄与するかはこの試験では確定できません。

### PM読み戻し診断

現ローカルCYW43ドライバ `c1075d4` の `cyw43_ll_wifi_pm()` は内部の設定ioctlの戻り値を検査せず、最後に0を返します。したがって上記の `pm_off=1` はPM無効化の証明ではありません。比較基準の稼働版を `/tmp/picow_pws2_tcp_only_reconnect.uf2` に保全した上で、Wi-Fi接続完了後に一度だけ公開 `cyw43_ioctl()` から `WLC_GET_PM` を読み、要求値 `CYW43_NONE_PM=0x10`（mode 0）と読戻しmode、読取りエラーをPi側ログへ載せる診断を追加しました。周期的な読み戻しはありません。PWS2の未使用だった11バイト目を使うため、状態パケットは60バイトのままです。`pm_readback=mode=0` は無効モードの読戻し、`mode=1/2` は省電力モードの読戻し、`error=N` はioctlエラー、`pending` は未取得を表します。PM設定の追加呼出しはしていません。

診断版のSPI0 UF2は `/tmp/picow_pm_readback_once.uf2` に保存しました。13件のソフトテストとクリーンビルドが成功しています。同じPico W（Flash ID `0xE661640843239D21`）へ転送し、Flash Verify 100%と起動を確認しました。固定IP `192.168.0.173`、SDK STA MAC `28:cd:c1:09:78:41` から再接続し、PWS2は `pm_off=1 pm_request=0x10(mode=0) pm_readback=mode=0` を報告しました。これは**最初のWi-Fi参加完了直後**のWLC_GET_PM読戻しが、省電力なしのmode 0だったことを示します。再接続後にPM値が維持されるかは測っていません。実機ログは `/tmp/picow_pm_readback_live.log` です。

動画サーバーは同じ588枚、6fps、ポート16151で継続中です。現在の非秘密起動引数には `--compensate-colors` と `--trace-motion` が含まれ、色補正は有効です。アプリは `pico_cyw43_arch_lwip_threadsafe_background` をリンクし、周期 `cyw43_arch_poll()` 方式ではありません。country code、SDK、PM設定値、動画プロトコル、LCD/SPI、受信窓、画面バッファは変更していません。

### 受信専用A/B版

表示版のCソースを `/tmp/picow_pm_readback_display.c`、表示版UF2を `/tmp/picow_pm_readback_once.uf2` に保全しました。受信専用版 `/tmp/picow_receive_only.uf2` は、動画ループ内の `lcd_show()` と表示時間計測だけをコンパイルから外します。LCD初期化と起動時3秒のテストパターンは従来どおりですが、動画フレームのLCD書込みはしません。受信フォーマット、2画面バッファへの格納と完成時のカウンタ更新、表示待ちスロットの解放、TCP処理、Wi-Fi維持、RSSI無効、PM設定と初回読み戻し、色補正には変更がありません。PWS2の既存フラグに `render=off` を表す1ビットを加えるだけで状態パケットは60バイトのままです。`displayed` は増えず、Piログは `display_rate=disabled` と表示します。

Piログの `completed` は `received + dropped` で、破棄分も含む25,600バイトのフレーム完了数です。`complete_delta` と `complete_rate` が受信完了枚数とfpsを示します。`rx_gap_max` はPicoの**受信コールバック間**の最大間隔で、完成フレーム間の最大間隔や画面停止時間ではありません。サーバーログの `send timeout` と `connected #` で送信タイムアウトと再接続を数え、Pi5で `ss -tin sport = :16151` の `bytes_retrans` を接続ごとに採取して再送を比べます。`bytes_retrans` は接続が変わるとリセットされるため、各接続の末値を集計します。表示版も同じログから `rx_delta + drop_delta` を状態報告間隔で割って受信完了fpsを算出できます。

受信専用版は14件のソフトテストとSPI0版UF2のクリーンビルドに成功し、警告はありません。同じFlash ID `0xE661640843239D21` のPicoへ転送し、Flash Verify 100%・起動を確認しました。色調査用の設定は変えていません。同じ588枚・6fps・2秒送信期限の動画連番0〜720（約120秒）の比較は以下のとおりです。状態報告は約1秒刻みで、動画連番による区切りのためfpsは概算です。

| 項目 | 表示版 | 受信専用版 |
| --- | ---: | ---: |
| 受信完了枚数 (`received + dropped`) | 約656枚 / 5.47fps | 約570枚 / 4.75fps |
| 実描画枚数 | 約603枚 / 5.03fps | 0枚（描画無効） |
| 完成後のスロット満杯による破棄 | 約53枚 | 0枚 |
| Pi送信タイムアウト / TCP接続 | 1回 / 2接続 | 3回 / 4接続 |
| Pico受信コールバック最大間隔 | 1,799ms | 1,792ms |

受信専用版ではPi側 `ss -tin` を0.25秒間隔で採取し、最初の約120秒の4接続について `bytes_retrans` の接続別観測最大値を合計すると**少なくとも1,096,380バイト**、同じサンプルでのACK済みバイトは約14,907,016バイトでした。RTO観測最大は3,456ms、指数バックオフ最大4、送信窓ゼロのサンプルはありません。再接続直前の値を採り損ね得るため再送数は下限です。表示版では同じ120秒の連続 `ss` 採取がないため、再送総量の定量比較はできません。別時点の表示版 `ss` 単発値は `bytes_retrans=80,400` / `bytes_sent=1,591,744` バイトで、再送の存在だけを示します。双方で送信停止と再送が観測され、LCD書込みを外しても通信停滞は残りました。順次測定中の無線状態の変動が大きいため、LCD負荷の小さな影響まで否定する結果ではありません。受信専用実機ログは `/tmp/picow_receive_only_live.log`、PiのTCPサンプルは `/tmp/picow_receive_only_tcp.tsv` です。

BOOTSEL回数を減らすため、後述のPWF2版ではPi側の配信モードをTCPヘッダーで指定し、同一バイナリ内でRAW/JPEGと描画の有無を切り替えます。USB CDCは追加していません。旧PWF1配信と新PWF2ファームには互換性がないため、切替時には両方を合わせました。

元JPEGは1枚904〜4,441バイト、平均3,004バイトです。現在送るのはJPEG/BMP/PNGではなく、Pi5で展開した非圧縮RGB565の25,600バイトです。Pico側JPEGデコードは今回実機で所要時間と成功数を測定しました。結果は後述します。液晶SPIは20MHzを要求しており、DMAを使わない `spi_write_blocking` による画面転送は通常約15.6ms（約64画面/秒の書込速度相当）、観測最大約64msでした。これはバス書込時間の測定で、液晶の可視更新上限や動画全体のfpsを示す値ではありません。

Picoの現行実装は25,600バイトの画面2枚を共有の受信/描画スロットとして使います。両方が表示待ちの時は新着1枚を破棄します。Pico側に別の先読みキューや6fpsの表示間隔制御はありません。追加バッファはバースト時の破棄を減らす可能性がありますが、実測の平均到着率約5fpsや数秒の送信停止を単独で解消しません。

## RAW/JPEG 同一ファーム比較（実機試験済み）

PWF2比較ファームは後述のとおり同じPico Wへ転送済みです。現在の配信プロセスもPWF2を使います。既存の16150番や他サービスは対象外です。

新ファームは1回の書込みで次の5モードを使えます。Pi側の `--mode` を変えて配信プロセスを再起動すると、PicoがTCP再接続して新モードを受け取ります。PicoのUSBシリアル、1200baudリセット、ROSは使いません。RGB565の経路も保持しており、JPEGは採用決定ではなく帯域対CPUの比較用です。

| `--mode` | 受信 | JPEG展開 | 動画描画 | 比較対象 |
| --- | --- | --- | --- | --- |
| `raw-rx` | 25,600B RGB565 | なし | なし | RAW転送のみ |
| `raw-display` | 25,600B RGB565 | なし | あり | 現行表示に相当 |
| `jpeg-rx` | 最大8,192B JPEG | なし | なし | 圧縮転送のみ |
| `jpeg-decode` | 最大8,192B JPEG | あり | なし | 展開CPU負荷 |
| `jpeg-display` | 最大8,192B JPEG | あり | あり | 圧縮動画全体 |

`PWF2` は20バイトの固定ヘッダーで、`magic(4) / sequence(u32) / width(u16) / height(u16) / payload_length(u32) / mode(u32)` をすべてbig endianで送ります。幅・高さは160×80固定です。モードは各TCP接続の間固定し、変更は再接続時に受け入れます。RAWは25,600B固定、JPEGは4〜8,192B。過大JPEGはPiの準備段階でファイル名とサイズを示して拒否し、Picoでも過大ヘッダーを拒否します。画像を黙って切りません。JPEG展開前にSOI/EOI、寸法を調べ、不正JPEGは `decode_failed` に数えて描画しません。JPEG受信のみのモードは意図的に画素内容を解釈しません。

Piは元の588枚を読み取って品質90のJPEGへ再圧縮します。現画像と色補正を適用した場合、588枚すべてが8KiB以下で、最小1,798B、平均4,868B、最大6,454B、合計2,862,508Bでした。RAWの合計15,052,800Bに対して約5.26分の1です。色補正はRAWでは従来のRGB565変換後、JPEGでは圧縮前のRGB画素に適用します。この違いとJPEGの再圧縮により画素値は完全一致しません。

比較の開始例（Picoへの新UF2転送後、既存の本プロジェクト配信を停止してから1モードずつ）:

```sh
cd /home/tane/dev/PicoW/PicoW_Youtube_Player
python3 -m server --host 0.0.0.0 --port 16151 --frames /home/tane/Videos/voltesV_6frame --fps 6 --mode raw-rx --compensate-colors --trace-motion
# Ctrl+Cで止めてから、--mode を raw-display, jpeg-rx, jpeg-decode, jpeg-display へ変更
```

`--fps` は6以外も指定でき、後の高負荷試験で同じフレーム群を繰り返せます。今回の一次比較は同じ6fps・同じ動画・同じ2秒送信期限で行います。送信予定fpsと、Picoの受信完了fps、JPEG展開時間、実描画fpsは別の値です。安定6fpsやそれ以上の描画性能は、このホスト試験とビルドからは結論できません。

新しい逆方向状態 `PWS3` は80バイトで、従来のPWS2 60バイトに `mode`, `decoded`, `decode_failed`, `last_decode_us`, `max_decode_us` を各u32で追加しました。従来の `received` はスロットに受け入れた完全フレーム、`dropped` はスロット満杯で破棄した完全フレーム、両者の和が受信完了枚数です。`displayed` はLCDに書き終えた枚数で、JPEG受信・展開のみでは0のままです。`decoded` はJPEG展開成功枚数、`decode_failed` は展開エラー枚数。SPI時間とJPEG展開時間を個別に記録し、モードが切り替わると時間の最大値をリセットします。Pi側はPWS1/PWS2/PWS3を読み取れます。

JPEG展開器はローカルLovyanGFXにあるTJpgDecのC/H 2ファイルだけを `pico/third_party/tjpgd/` へコピーし、ライセンスコメントを保持しました。出典と条件は `THIRD_PARTY_NOTICES.md` を参照してください。ホストでデコーダの全588枚展開、不正/切断JPEG、過大JPEG、159×80の寸法違いを検査しました。Pico向けクリーンビルドのBSSは166,068B、`__end__=0x20028d9c` から `__StackLimit=0x20040000` まで94,820B残ります。別に8KiBのスタック領域が予約されています。この静的見積りは実行時ヒープ使用量の証明ではありません。転送に使用したUF2は `/tmp/picow_raw_jpeg_multimode_unflashed.uf2`（634,880B、SHA256 `9432eda69a5f5dc156e805304be1d91d3c49817bc4dcf56d0edf7d209547cec1`）です。ソフト試験17件が成功しました。ホスト上の展開時間はPicoの実測値ではありません。

この通信比較時点では旧LovyanGFXのST7735S初期化にgamma設定があり、当時のドライバにはありませんでした（後述のB版で追加・採用済み）。ただし現パネルの初期gamma値を確実に読み戻して復元する方法は確認できていないため、今回の同一ファームにはgamma切替を入れていません。通信比較では現行の色補正・`LCD_INVERT=1`・`LCD_MADCTL=0x60`・Yオフセット24を維持します。色調の比較は別の条件を混ぜずに行います。

### 同一Pico WでのRAW/JPEG実機比較（2026-10-08）

ユーザーがBOOTSEL接続した単一PicoのFlash ID `0xE661640843239D21` を従来機と照合し、上記PWF2 UF2を `picotool load -v -x` で転送しました。Flash Verify 100% OK、起動後のPWS3で固定IP `.173`、STA MAC `28:cd:c1:09:78:41`、各モードの受信・展開・表示カウンタを確認しました。配信は本プロジェクトの16151番だけを切り替え、他サービスとPicoのUSBシリアルには触れていません。

同じ588枚、Pi側の反転＋R/B色補正、6fps時刻、2秒送信期限を固定し、`raw-display → raw-rx → jpeg-rx → jpeg-decode → jpeg-display → raw-display` の順に各モード約100秒ずつ配信しました。下表は各ログの最初のPWS3状態から約75秒後に最も近い状態までのカウンタ差です。状態報告の無線遅延により実際の区間は73.79〜76.09秒です。`受信完了` は受入れ＋スロット満杯破棄で、`表示` はLCD書込み完了です。

| モード | 実状態区間 | 受信完了 | 受信完了率 | 展開成功 | 表示完了 | 表示率 | 満杯破棄 |
| --- | ---: | ---: | ---: | ---: | ---: | ---: | ---: |
| RAW表示・先 | 76.09秒 | 271 | 3.56fps | ― | 240 | 3.15fps | 31 |
| RAW受信のみ | 75.38秒 | 311 | 4.13fps | ― | ― | ― | 1 |
| JPEG受信のみ | 73.79秒 | 378 | 5.12fps | ― | ― | ― | 9 |
| JPEG展開のみ | 75.07秒 | 411 | 5.48fps | 401 | ― | ― | 10 |
| JPEG表示 | 75.07秒 | 331 | 4.41fps | 307 | 307 | 4.09fps | 23 |
| RAW表示・後 | 74.65秒 | 363 | 4.86fps | ― | 336 | 4.50fps | 27 |

各モードの約100秒の配信全体で、Piの送信タイムアウトは順に **5 / 4 / 2 / 3 / 4 / 2回**、TCP接続数は **6 / 5 / 3 / 4 / 5 / 3** でした。0.5秒間隔のPi `ss -tin` 観測から接続ごとの最大再送バイトを合計した下限は順に **887,460 / 841,540 / 137,980 / 32,782 / 107,364 / 781,220B** です。切断直前の採り損ねを含むため下限です。どのモードも送信窓ゼロのサンプルはありませんでした。Pi側1回の送信待ちは2秒期限で切れましたが、PWS3の到着間隔最大は順に約10.9 / 10.3 / 9.8 / 10.1 / 11.8 / 6.5秒で、これは表示停止の厳密な長さではありません。

Pico実機のJPEG展開は最後の状態値で約26ms（展開のみ）・28ms（JPEG表示）、起動以来ではなくモード切替時にリセットする最大値は約39msでした。JPEG表示のSPI書込みは約15.6ms、同モード最大約21.6ms。JPEG展開失敗はこの約100秒比較と短い事前表示試験で0でした。JPEG展開＋SPIは通常約44msですが、Wi-Fi損失やフレーム破棄を含む実効表示率は4.09fpsで、6fps安定表示は実証できません。BSS166,068B、リンク時空き94,820Bで、実機で約100秒間JPEG展開が継続したことは確認しましたが、実行時のヒープ最小余裕は計測していません。

RAW表示は測定順の先後で3.15→4.50fpsと大きく変わりました。JPEG展開のみがJPEG受信のみより高いfpsになったのも、処理追加による改善ではなく時間帯の通信変動を含むことを示します。この順次試験からJPEG採用やCPU負荷の有利不利を断定しません。RAW経路を残し、ユーザーの意向どおりCPUを高fpsに使う選択肢を維持します。6fpsは素材の値で性能上限ではありません。高fps配信は今回実施していません。

旧OpenCV 4.6.0の `cv::imread`＋`cv::imencode(..., IMWRITE_JPEG_QUALITY,90)` を同じ588枚で再現すると最大6,539B、平均4,876Bでした。今回のPiサーバーは **Pillow** 品質90を使い、色補正前の最大6,557B、色補正後の最大6,454B・平均4,868Bです。最大値の差にはJPEGエンコーダと色補正の両方が含まれます。どちらも8KiB以内です。

測定概要は `/tmp/picow_multimode_ab_summary.json`、約75秒窓は `/tmp/picow_multimode_ab_75s.json`、各モードのPico/PiログとTCPサンプルは `/tmp/picow_multimode_ab_<番号>_<モード>.log` と `_tcp.log` に保存しました。比較終了後は**最後のRAW表示モードを16151番で継続配信中**です。新ファームでの実画面の色・動きについて、ユーザーの目視評価はまだありません。

## CYW43初発損失の計装版

credit待ち中のDATA破棄と送信バッファ変化を共有SDKから隔離した診断版を実機へ転送して測定しました。ソース照合、PWS4項目、初発損失調査の実測は [docs/diagnostics/CYW43_CREDIT_TEST.md](../../docs/diagnostics/CYW43_CREDIT_TEST.md) を参照してください。

## Pi5有線経路の6fps・上限FPS追試

Pi5の既存Wi-Fi `192.168.0.120` / 既定経路 / DNSを維持し、Pico宛て `.116 → .173` だけを一時eth0へ送りました。同じRAW6fpsで実描画はWi-Fi **5.312fps**、有線 **6.000fps**、画面スロット破棄は56→0枚。限定ヘッダーcaptureではeth0の送信・受信双方を確認しています。ユーザーも有線でカクつきが大きく減ったことを確認しました。

現SPI設定からの純転送理論値は約76.3fpsです。有線76fps設定では完成フレーム約69.2fpsに対し、CPUを使うSPI処理時間が伸びて描画は約8.4fpsでした。32fps設定では実描画約30.0fpsで、これが今回測った範囲の最高値ですが、スロット満杯による破棄は119枚あります。上限値の根拠・各負荷・12fps追試・一時設定と復元状態は [docs/diagnostics/WIRED_ETH0_PREP.md](../../docs/diagnostics/WIRED_ETH0_PREP.md) に記録しています。

高fps試験では元の588枚を速く送っており、6fps素材の再生速度も上がります。元JPEGは変更していません。ネイティブ高fps動画の画質/滑らかさやLCDパネルの走査上限は別の確認事項です。今回の有線IP/限定routeは試験用で、恒久化していません。

## 検証フェーズFixと次フェーズ

ユーザー決定によりPi5 Wi-Fi `.120` / RAW6fpsへ復元しました。同一Flash IDのPicoへ元のUF2をVerify付きで転送し、接続・受信/描画増加・wlan0双方向通信を確認しています。一時policy ruleは撤去済みで専用table16151は空です。NASケーブル返却の確認後に、一時eth0プロファイル撤去と旧有線autoconnectを復元する後片付けが残っています。

成功・未達・現運用制約は [docs/VERIFICATION_FIX.md](../../docs/VERIFICATION_FIX.md)、次フェーズのURL指定/FPS選択/キャッシュ・履歴/容量管理/連続再生の棚卸しは [docs/YOUTUBE_REQUIREMENTS_INVENTORY.md](../../docs/YOUTUBE_REQUIREMENTS_INVENTORY.md) を参照してください。新しいYouTube実装、常駐化、有線恒久化、コミットはこの復元作業で開始していません。

## プロジェクト配置

Pico本体、配信本体、診断コード、証拠、文書を分離しました。[docs/PROJECT_LAYOUT.md](../../docs/PROJECT_LAYOUT.md) に配置・起動・ビルド・検証を記録しています。ルートの`server.py` / `diagnostic.py` / `requirements.txt`は既存コマンド用の互換入口です。秘密設定`config.h`はルートで保持しています。

## Web URLプレーヤー（2026-10-08）

**http://192.168.0.120:16152** で稼働中。Pi5向け `picow-player.service` はuser managerでenabled/active。Pico向けTCPもPi5 `.120:16151` で待受し、Pico `.173` の接続と描画カウント増加、動画周回を確認しました。専用サービスの実再起動でも保存した最後の選択を復元します。Pi5本体の再起動後の実測は未実施です。既存本番16150は変更していません。

URL直接入力、FPS6/12/18/24/30、全編/開始終了指定、履歴、使用量、確認削除、完成後の先頭切替、1動画ループ、日本語ダークUIを実装しました。新規保存は160×80 JPEG連番を普通のフォルダへ置き、送信時にPi5でRGB565へ展開します。Web変換はcropをやめ、元動画全体を縦横比維持で縮小し、余白を黒にします。旧切出しJPEGとRAWは保全し、新規取得は240p相当を優先します。TCPへ送るのは従来のRGB565なので通信量は変わりません。

旧切出し条件で測った既存59秒素材のJPEG変換は6fpsで1.518秒/977,378B、30fpsで2.276秒/4,891,787B（取得時間を含まない）。ユーザー指定動画の1:34〜最後はHTTP403対処後の再試行で取得・変換が約75秒で完了し、1,678枚/2,877,215Bを配信・周回しました。HTTPS機能不足はユーザーの更新で解消済み。403には取得形式の確認と1回限定の新URL/HLS再試行を追加しましたが、YouTube側の拒否条件は未確定です。

JPEGフォルダ、縦横動画の四辺保持・黒余白を含む42テスト成功。全体表示への修正時、小笠原動画は保存済み元動画から4.390秒で再変換し、JPEG2,853枚/6,280,748Bを通常フォルダに保存して配信中。実Chromeのダーク表示と390px幅を確認済み。今回のWeb修正にPico書込み・USB操作やネットワーク設定変更は行っていません。ガンマは後述のB版でユーザーが明確な目視改善を確認しました。24時間耐久は未実施です。詳細と起動・停止・再起動は [Webプレーヤー仕様・実行方法](../../docs/WEB_PLAYER.md)、[設定例](../../web-config.example.json)、[user unit](../../deploy/picow-player.user.service.example)、[実測記録](../../docs/verification/web-service.json) を参照してください。

## LCD色調の比較（B転送・通常Web復帰済み）

現行転送記録に一致する復帰用UF2と、旧LovyanGFXのE0/E1ガンマ表一組だけを追加する比較版を準備しました。ガンマOFF再ビルドは現行UF2とバイト単位で一致、同じRelease/SPI0/CYW43診断構成のON版もビルド成功。44ソフト試験成功。同じ静止写真・灰色階段・RGB濃淡を既存の色補正とPWF2 RAW経路で比較する手順と実機記録は [LCDガンマ比較](../../docs/diagnostics/LCD_GAMMA_AB.md)。ユーザー承認後、同一Flash IDを照合してBを転送し、Flash Verify 100%と3種類の固定画像の受信/描画を確認しました。ユーザーは「いい！すごく良くなった。全然ちがうよ。」と目視改善を確認しました。Bのガンマ設定を維持します。同一写真のA基準による改善量の定量測定は未実施です。その後の依頼で比較配信だけを終了し、Bを保ったまま [通常Web](http://192.168.0.120:16152/) へ復帰しました。保存済み動画の再開とPico描画を確認済みです。

## 採用ガンマ・完成判定・基板案

通常ビルドの `PLAYER_LCD_GAMMA_LGFX` はONを既定とし、採用済みE0/E1表を `pico/lcd_gamma_lgfx.h` に配置しました。CYW43通信診断の有無に依存せず使えます。既存CMakeキャッシュがOFFなら既定値の変更だけでは上書きされないため、上の通常ビルド手順ではONを明示します。比較用Aを再現する場合だけOFFを指定します。実機のBや通常Webを再起動・再転送する必要はありません。

FPS変更はPi5でキャッシュ選択/変換と送信周期を変更し、Picoは受信した完成フレームを表示します。6/12/18/24/30に固定6fpsの制限はなく、FPS変更だけなら再書込みは不要です。ハブ導入後の合格目標は本番JPEGフォルダ→Pi5復号→RAW送信の**有線24fps安定描画**、30fpsは任意確認です。この本番経路の有線24fps試験はまだ行っていません。接続先IPを変える場合は別途設定とPico再転送が必要です。

[背中合わせ図](../../docs/compact-layout.svg)は縮尺・実物寸法未確定の概念案で、加工用/完成配線の承認図ではありません。物理1〜20番側へ信号を寄せるSPI1案、表裏反転、条件付きBLKジャンパを記録しています。採寸・端子順・アンテナ空間を確認してから作業します。現在の配線での映像・色・全画面表示は確認済み。BLK候補配線の回路/電流は未確認です。

通常ガンマ採用後の44テスト成功。診断ON再ビルドのUF2は稼働Bと全バイト一致、診断OFFの通常版もビルド成功。証拠は [通常採用確認](../../docs/verification/gamma-adoption.json)。実機再転送・サービス再起動は行っていません。

## ケース収納後: ボタン単体診断と動画180度回転

2026-10-10。GP12〜15の4ボタンを確認するWi-Fi不要の別ターゲットを準備し、ユーザーBOOTSEL連絡後に同一Flash IDへVerify転送済み。実画面のWAIT/4図形は、はんだ不良修理後にユーザーがテストOKと確認しました。本番は採用ガンマと正しいLCD窓のまま画素順を180度反転する `PLAYER_ROTATE_180=ON` を新規ビルド既定にしました。その後のBOOTSEL連絡で動画回転版も同一Flash IDへVerify転送し、既存サーバーへの再接続・受信/描画増加を確認しました。ユーザーが実画面の180度方向・色・画面の収まりを確認し、YouTubeデバイス完成を承認しました。FPS/TCP処理、ボタン本番機能、OS/ネットワーク/サービス設定は変更していません。[診断手順・成果物・転送結果](../../docs/diagnostics/BUTTONS_ROTATION.md)を参照してください。
