tanep3/PicoW_Youtube_Player/(commit log)

2026-10-10 Add button diagnostics and rotate video display 180 degrees
2026-10-10 Document maker setup, import final case v3 and add MIT license
    [00_all_parts_A1mini.stl, 01_shell.stl, 02_lid.stl, 03_button_row_1.stl, 04_button_row_2.stl, YouTube_LCD_Case_SLIM_Fit_v3.blend]
2026-10-10 Avoid cache scans and lock contention during playback
    [test_web.py]
